KlausMichalsky/ChessBot---Zero_Documentation/Comandos_Stockfisch-Run.pdf

# ZERO-CHESS - Guía simple de comandos

¿Por qué existe ~?
El símbolo ~ no tiene nada que ver con GitHub.
Representa tu carpeta personal en la Raspberry Pi:
/home/klaus

Cuando haces 'cd ~', estás entrando a tu propio sistema local.
GitHub solo guarda el código en internet, pero tú lo descargas aquí (clon).

FLUJO REAL:
GitHub → lo descargas → queda en tu Raspberry Pi → lo ejecutas localmente

COMANDOS IMPORTANTES:

1) Entrar al proyecto
cd ~/ChessBot---Zero
= entrar a la carpeta del robot en tu Raspberry Pi
2) Activar entorno Python
source venv/bin/activate
= activar librerías del proyecto (chess, serial, etc.)
3) Ejecutar el robot
python pico/main_auto.py
= arranca el sistema completo (Stockfish + robot)

RESUMEN SIMPLE:
cd → entro al proyecto
source venv → enciendo Python correcto python main → arranco el robot
