KlausMichalsky/ChessBot---Zero_Documentation/2026-01-17 - MCU Pins.pdf

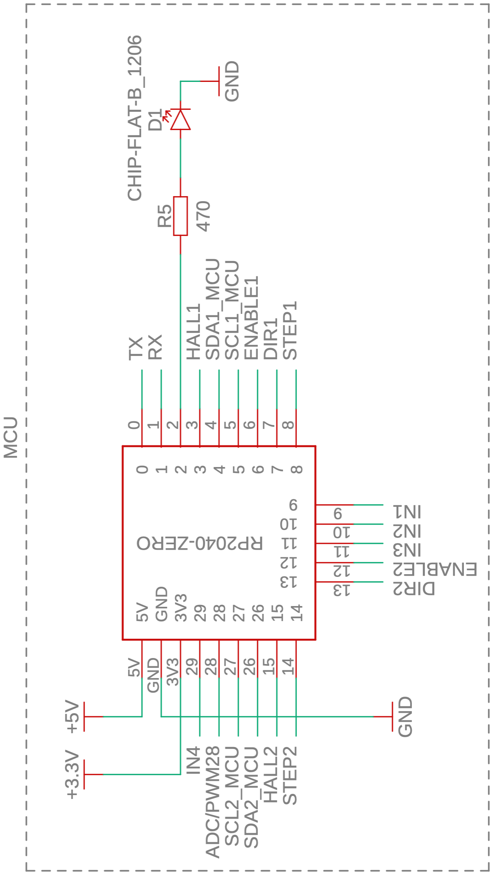
[picture p2: page 1]
