KlausMichalsky/ChessBot---Zero_Documentation/img/2026-01-26 - IMG_0988.jpeg

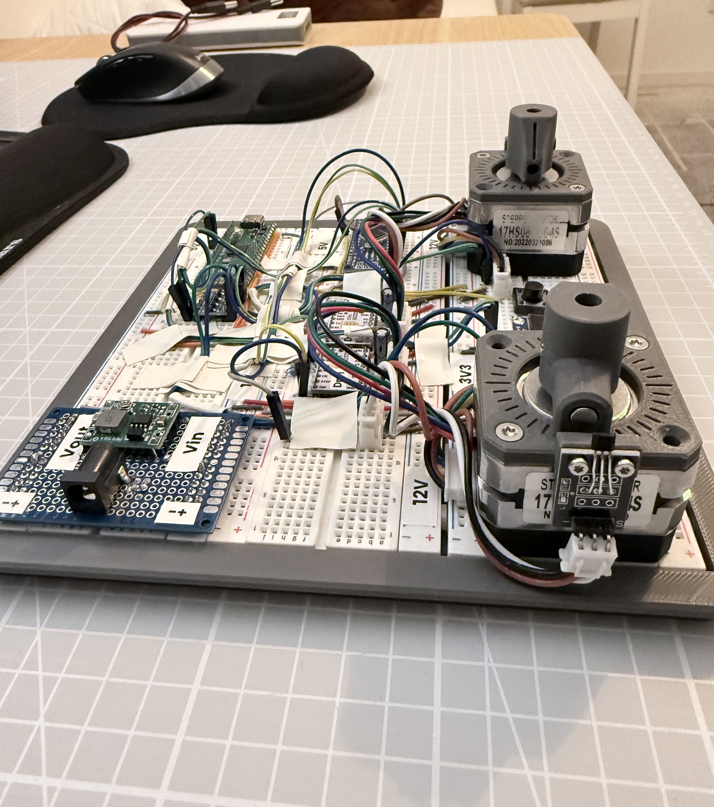
img/2026-01-26 - IMG_0988.jpeg
