KlausMichalsky/ChessBot---Zero_Documentation/img/2026-03-01 - IMG_1122.jpeg

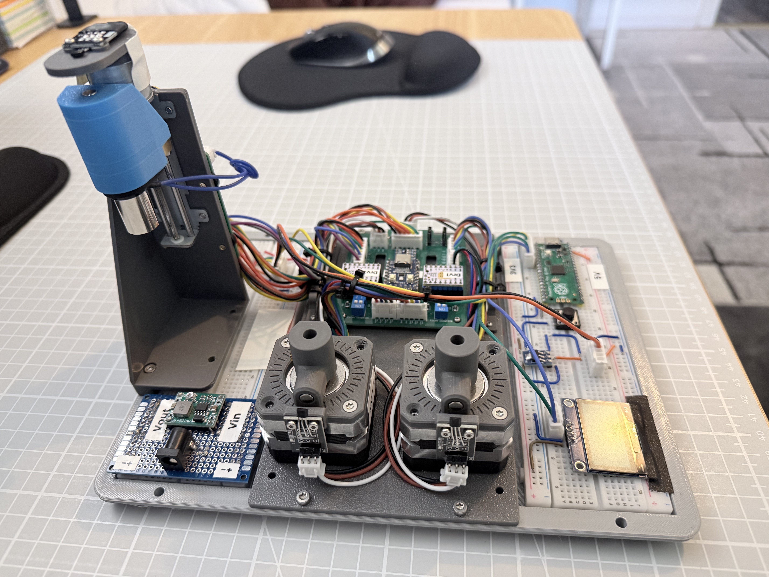
img/2026-03-01 - IMG_1122.jpeg
