KlausMichalsky/ChessBot---Zero_Documentation/img/2026-03-01 - IMG_1124.jpeg

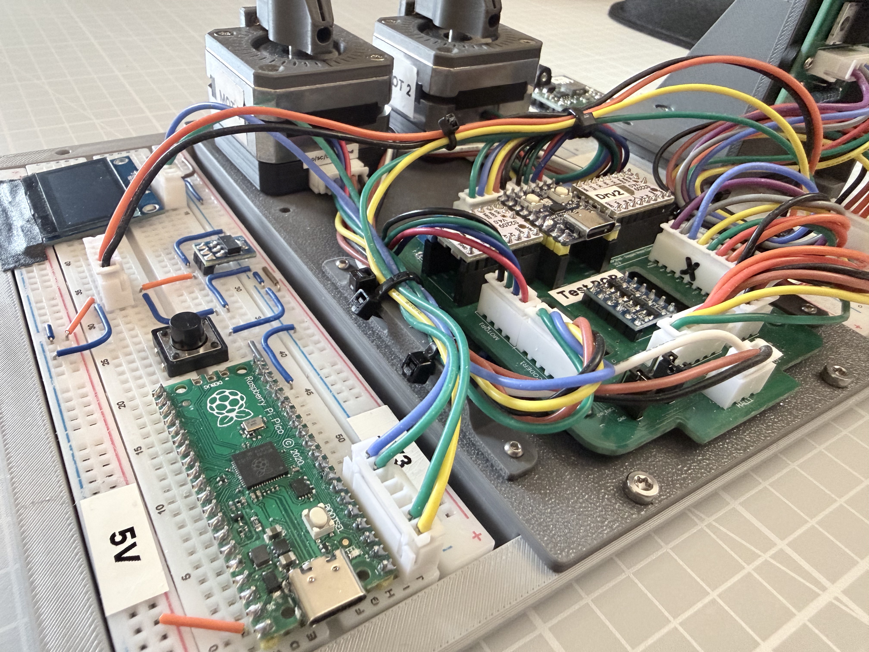
img/2026-03-01 - IMG_1124.jpeg
