KlausMichalsky/ChessBot---Zero_Documentation/img/Flujo de main.py.png

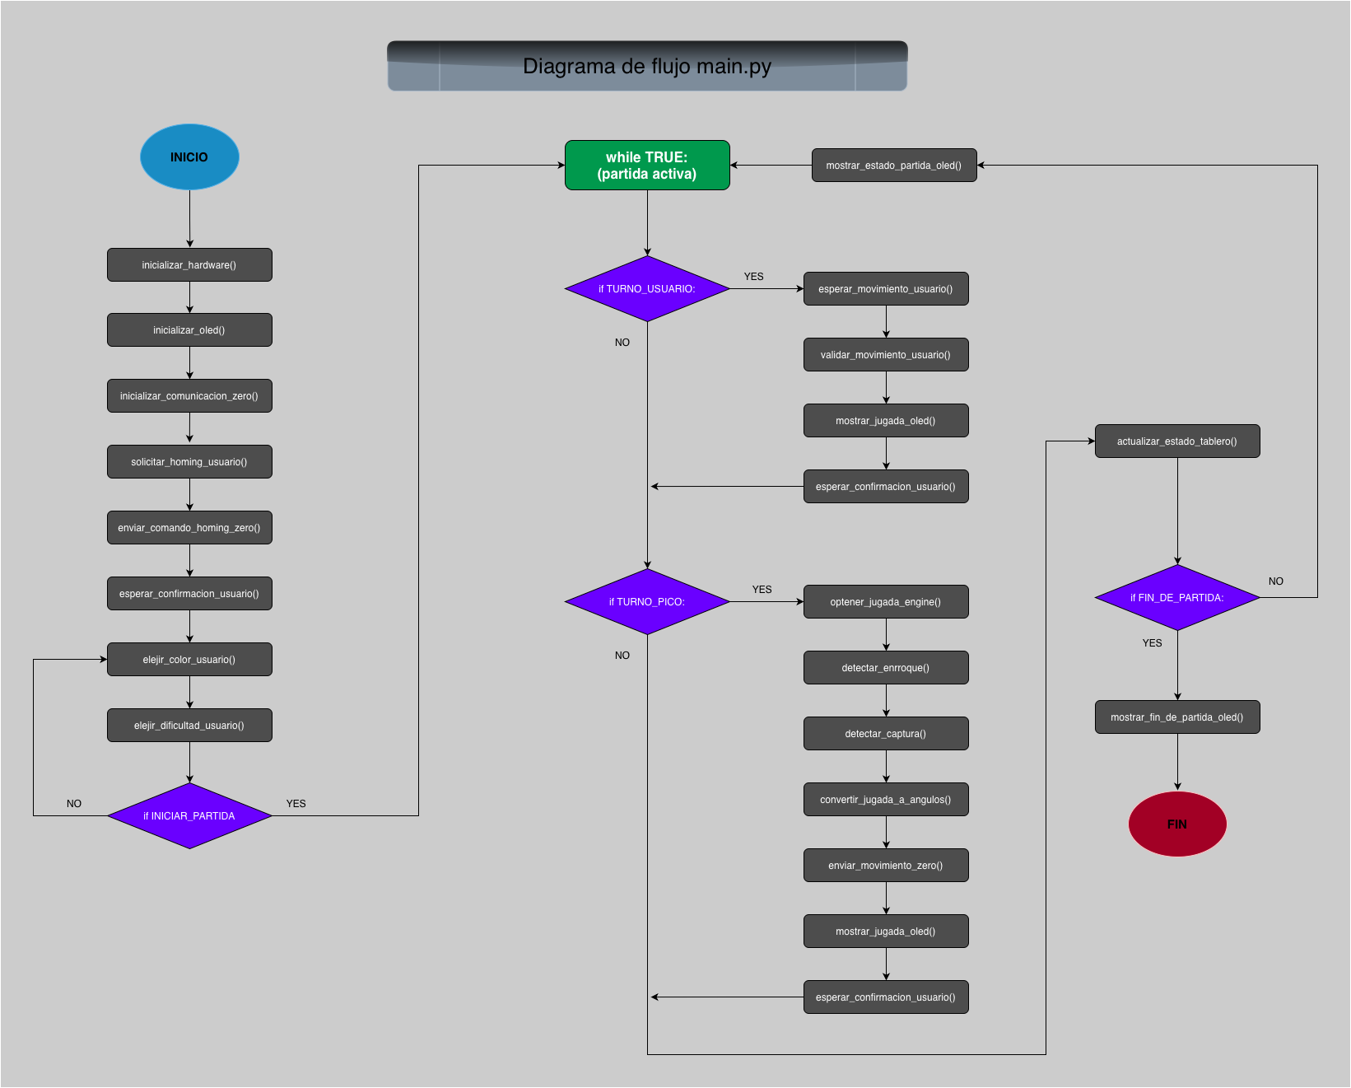
img/Flujo de main.py.png
