KlausMichalsky/ChessBot---Zero_Documentation/img/Flujo de main_zero.ino.png

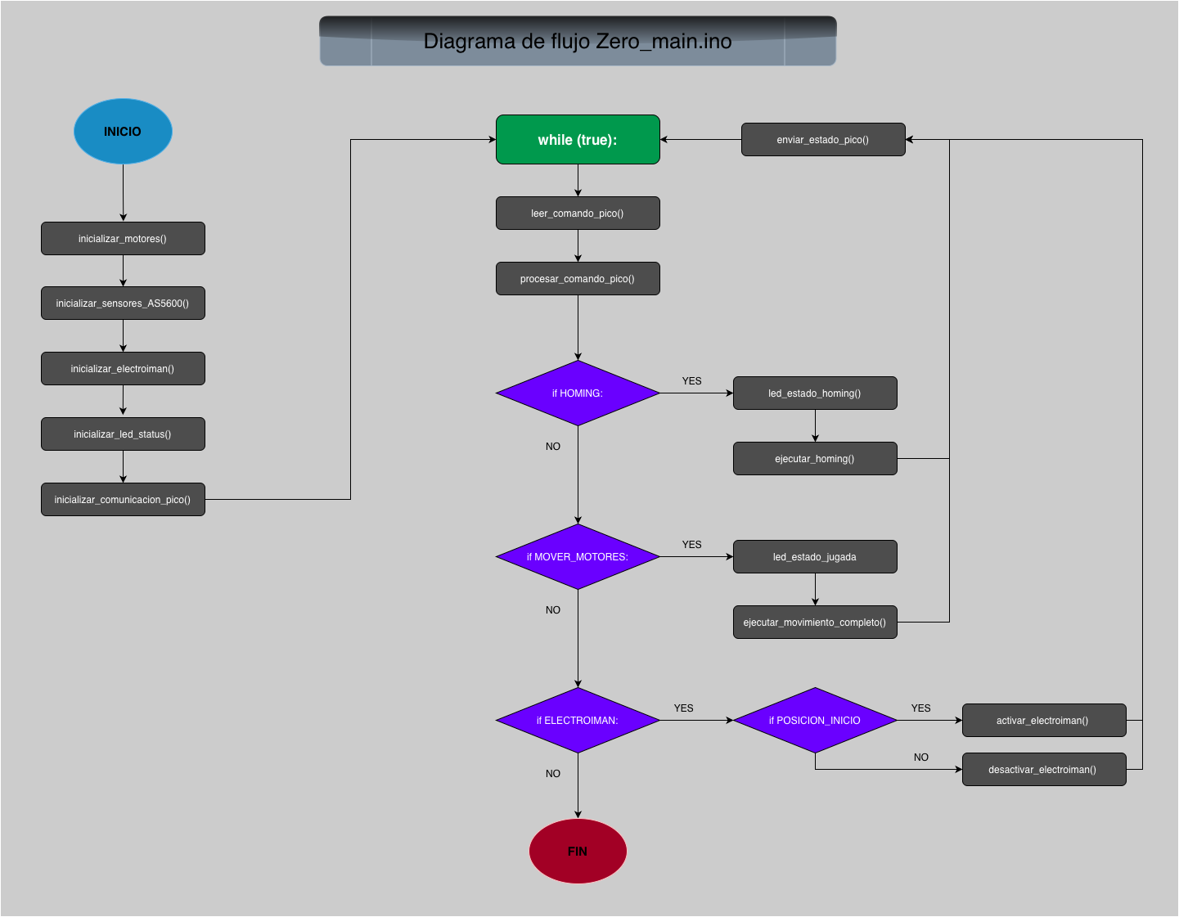
img/Flujo de main_zero.ino.png
