KlausMichalsky/ChessBot---Zero_Documentation/img/Maquina de estados Raspy.png

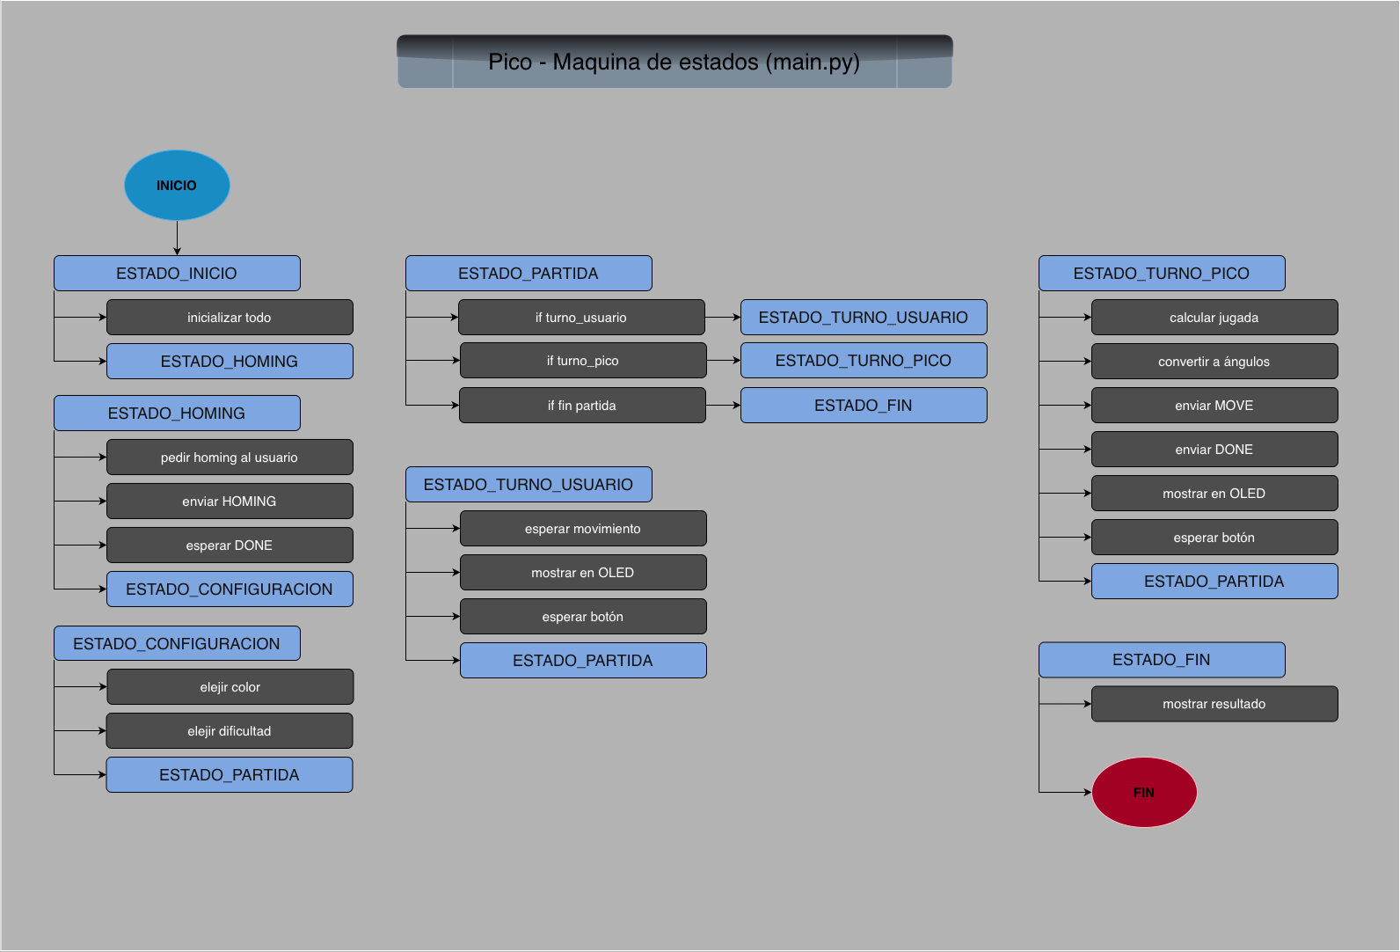
img/Maquina de estados Raspy.png
