KlausMichalsky/ChessBot---Zero_Documentation/img/Maquina de estados Zero.png

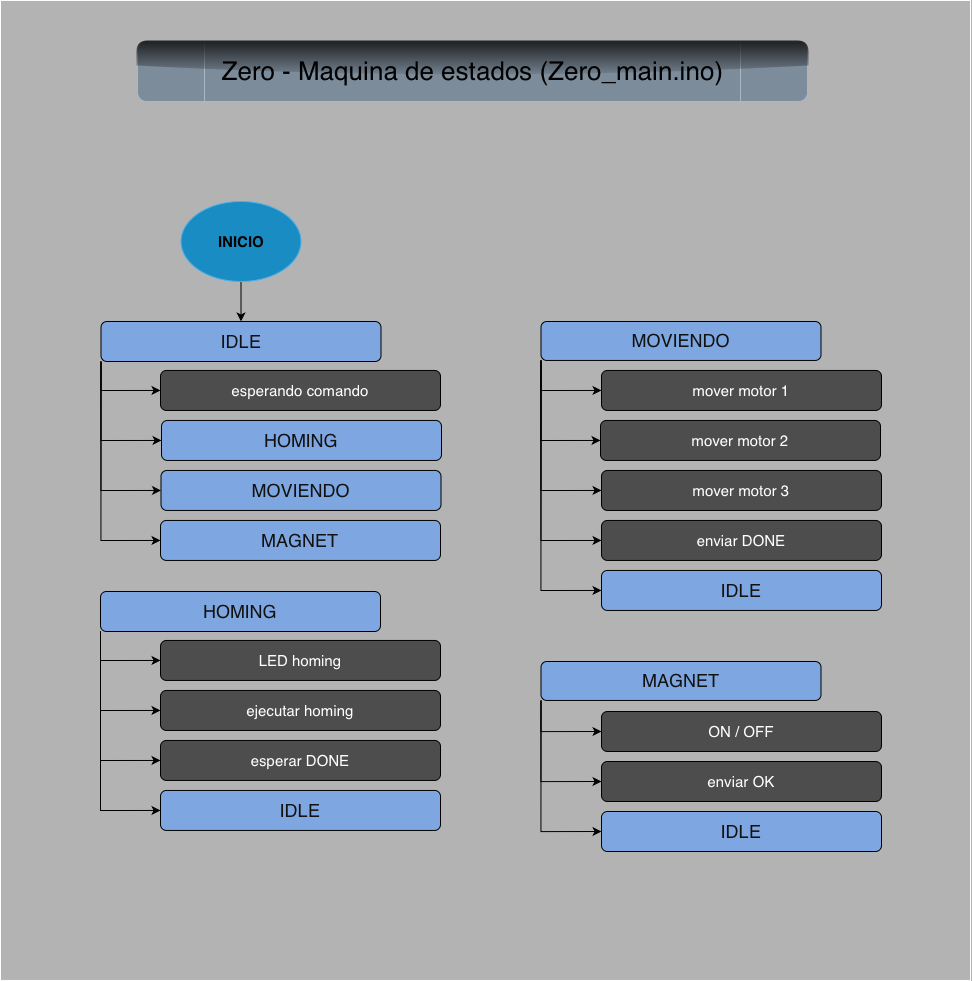
img/Maquina de estados Zero.png
