KlausMichalsky/ChessBot---Zero_Documentation/img/Move-Command.png

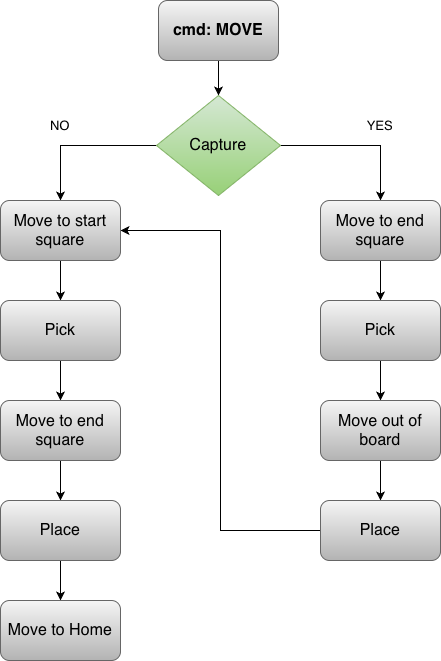
img/Move-Command.png
