KlausMichalsky/ChessBot---Zero_Documentation/img/# Logo #.DXF

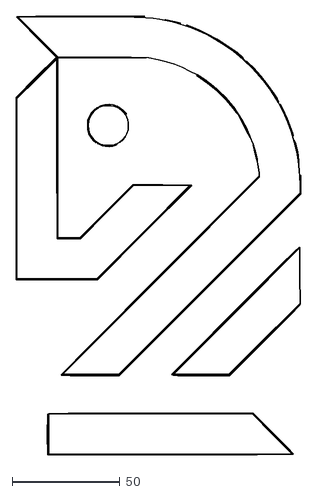
[picture p22: CAD file, 2026-02-28]
img/# Logo #.DXF
132.3 x 203.7
