KlausMichalsky/ChessBot---Zero_Documentation/Checklist_Stockfish-Install.pdf

# ■■ ZERO---CHESS CHECKLIST

Estado actual del sistema (Raspberry Pi + Stockfish)

## 1. Preparación SD

Raspberry Pi Imager instalado microSD (8–32 GB)
Raspberry Pi OS instalado
SSH activado
Usuario: klaus
WiFi configurado
Hostname configurado

## 2. Conexión SSH

ssh klaus@192.168.178.48
✔ Conexión establecida

## 3. Sistema actualizado

sudo apt update
sudo apt upgrade -y
✔ Sistema actualizado

## 4. Stockfish

sudo apt install stockfish -y stockfish
✔ Stockfish 17.1 funcionando

## 5. Herramientas de desarrollo

sudo apt install git cmake build-essential -y ✔ git instalado
✔ cmake instalado
✔ build-essential instalado

## 6. Verificación

cmake --version → 3.31.6

✔ herramientas OK

## 7. Prueba UCI Stockfish

uci
isready
position startpos moves e2e4 go depth 10
✔ bestmove e2e4

## ESTADO FINAL

✔ Stockfish funcionando
✔ UCI OK
✔ entorno de desarrollo listo
✔ sistema preparado para Zero---Chess
