KlausMichalsky/ChessBot---Zero_Documentation/2025-12-29 - E1 - Modulo RP2040-Drivers.pdf

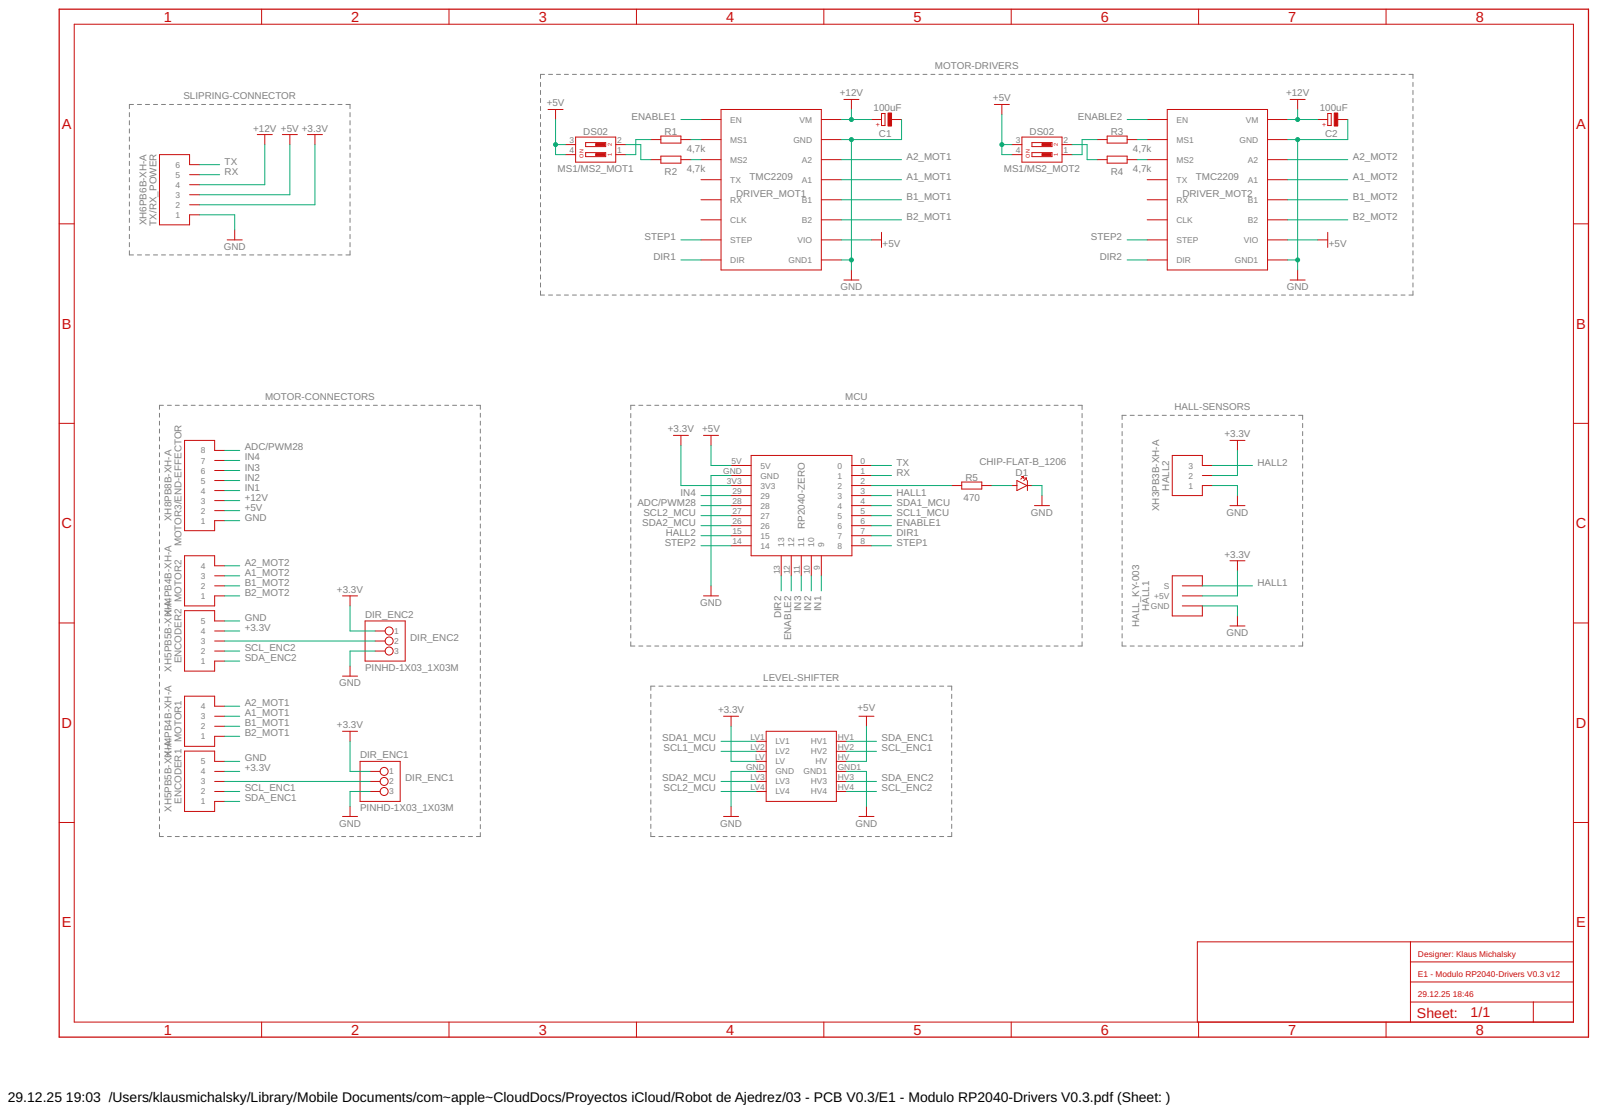
[picture p27: page 1]

Designer: Klaus Michalsky E1 - Modulo RP2040-Drivers V0.3 v12

29.12.25 19:03 /Users/klausmichalsky/Library/Mobile Documents/com~apple~CloudDocs/Proyectos iCloud/Robot de Ajedrez/03 - PCB V0.3/E1 - Modulo RP2040-Drivers V0.3.pdf (Sheet: )
