KlausMichalsky/ChessBot---Zero_Documentation/2026-01-17 - E2 - Extension board1 v3.pdf

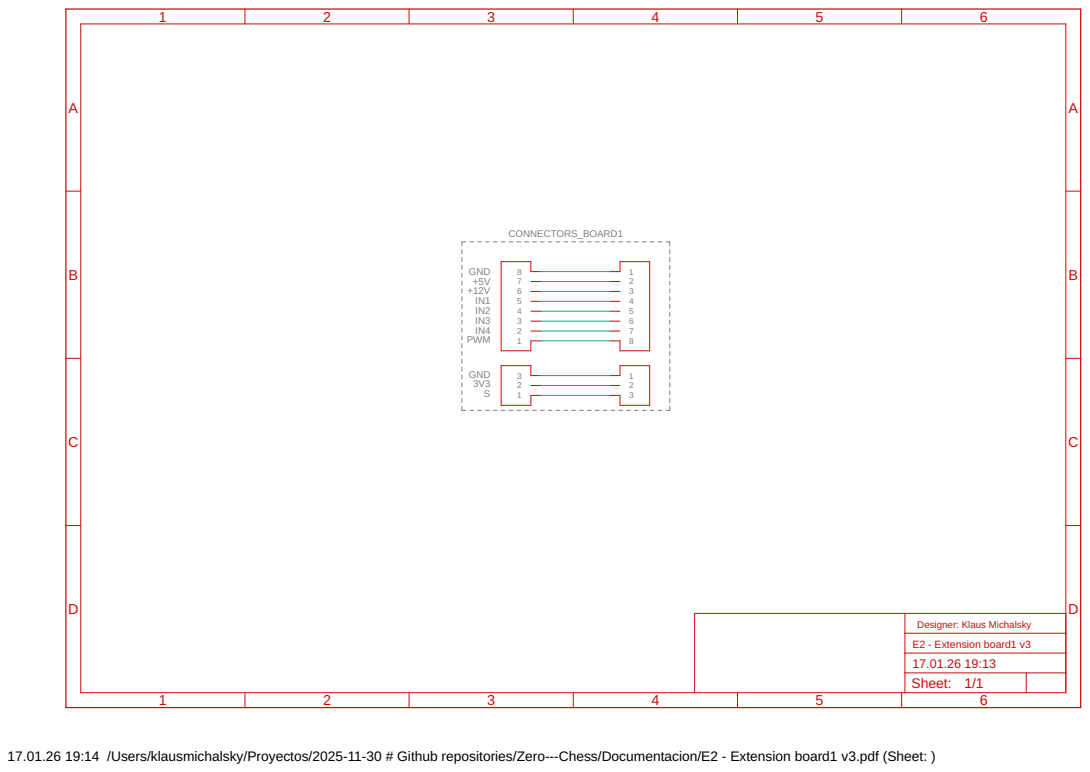
[picture p30: page 1]

17.01.26 19:14 /Users/klausmichalsky/Proyectos/2025-11-30 # Github repositories/Zero---Chess/Documentacion/E2 - Extension board1 v3.pdf (Sheet: )
