KlausMichalsky/ChessBot---Zero_Documentation/2026-01-17 - E2 - Extension board2.pdf

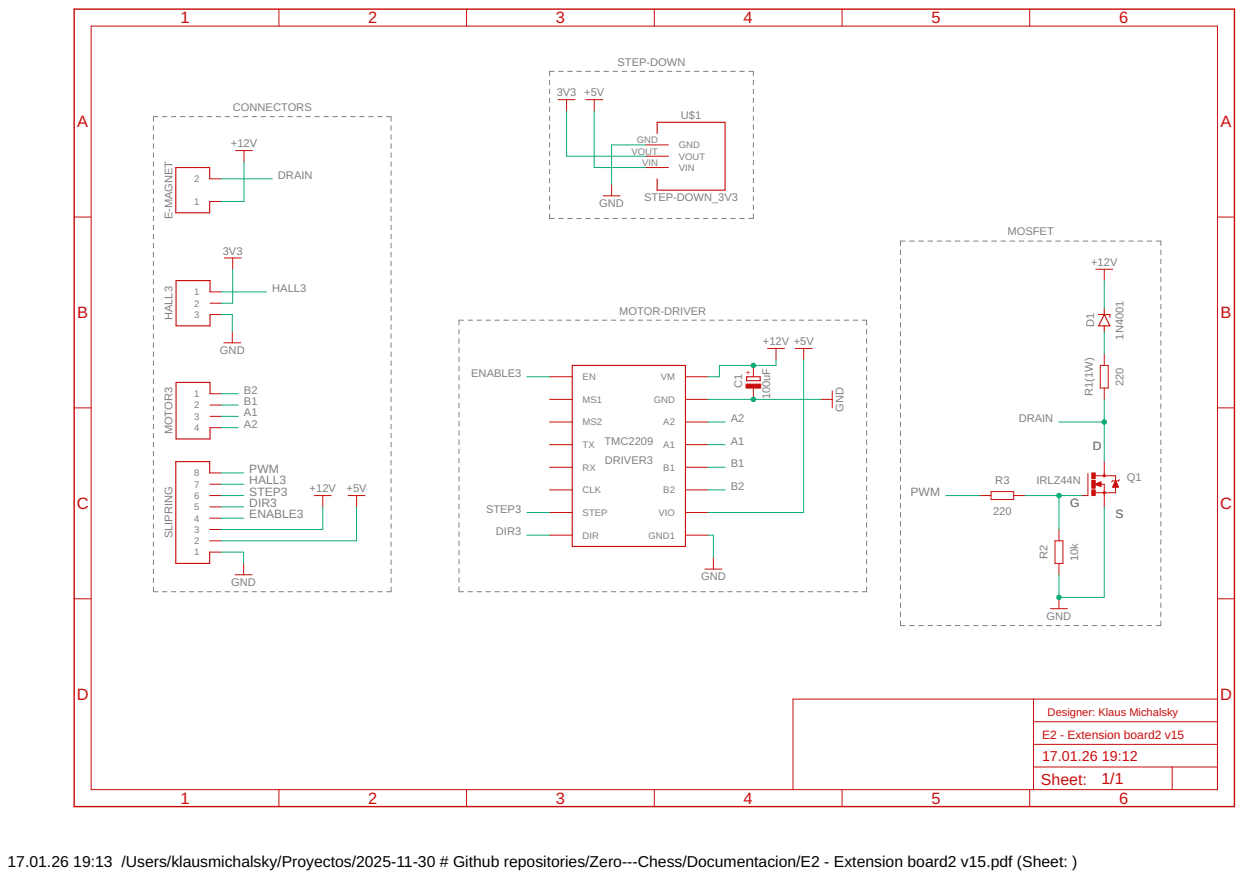
[picture p31: page 1]

17.01.26 19:13 /Users/klausmichalsky/Proyectos/2025-11-30 # Github repositories/Zero---Chess/Documentacion/E2 - Extension board2 v15.pdf (Sheet: )
