KlausMichalsky/ChessBot---Zero_Documentation/(commit log)

2026-02-28 Add homing configuration for motor3 and clarify timeout comments
2026-03-06 responsabilidades de modulos
2026-03-08 Declaraciones externas de las variables globales
